NicoF46/EstimuladorTermico/README.md

# EstimuladorTermico
Estimulador térmico para trabajo profesional
