NicoF46/EstimuladorTermico/Documentacion/ModeloTermico/ConductividadTermicaTabla.png

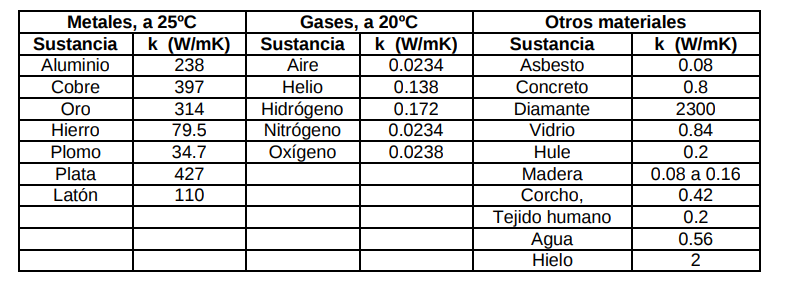
Documentacion/ModeloTermico/ConductividadTermicaTabla.png
