NicoF46/EstimuladorTermico/Documentacion/Plaquetas/Placa V2/esquematico.png

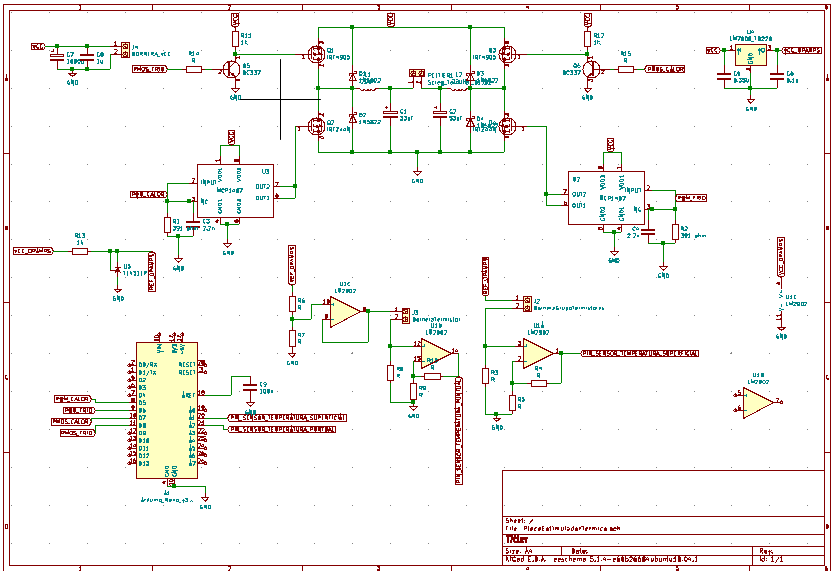
Documentacion/Plaquetas/Placa V2/esquematico.png
