NicoF46/EstimuladorTermico/Documentacion/Plaquetas/Placa V2/Schematic.pdf

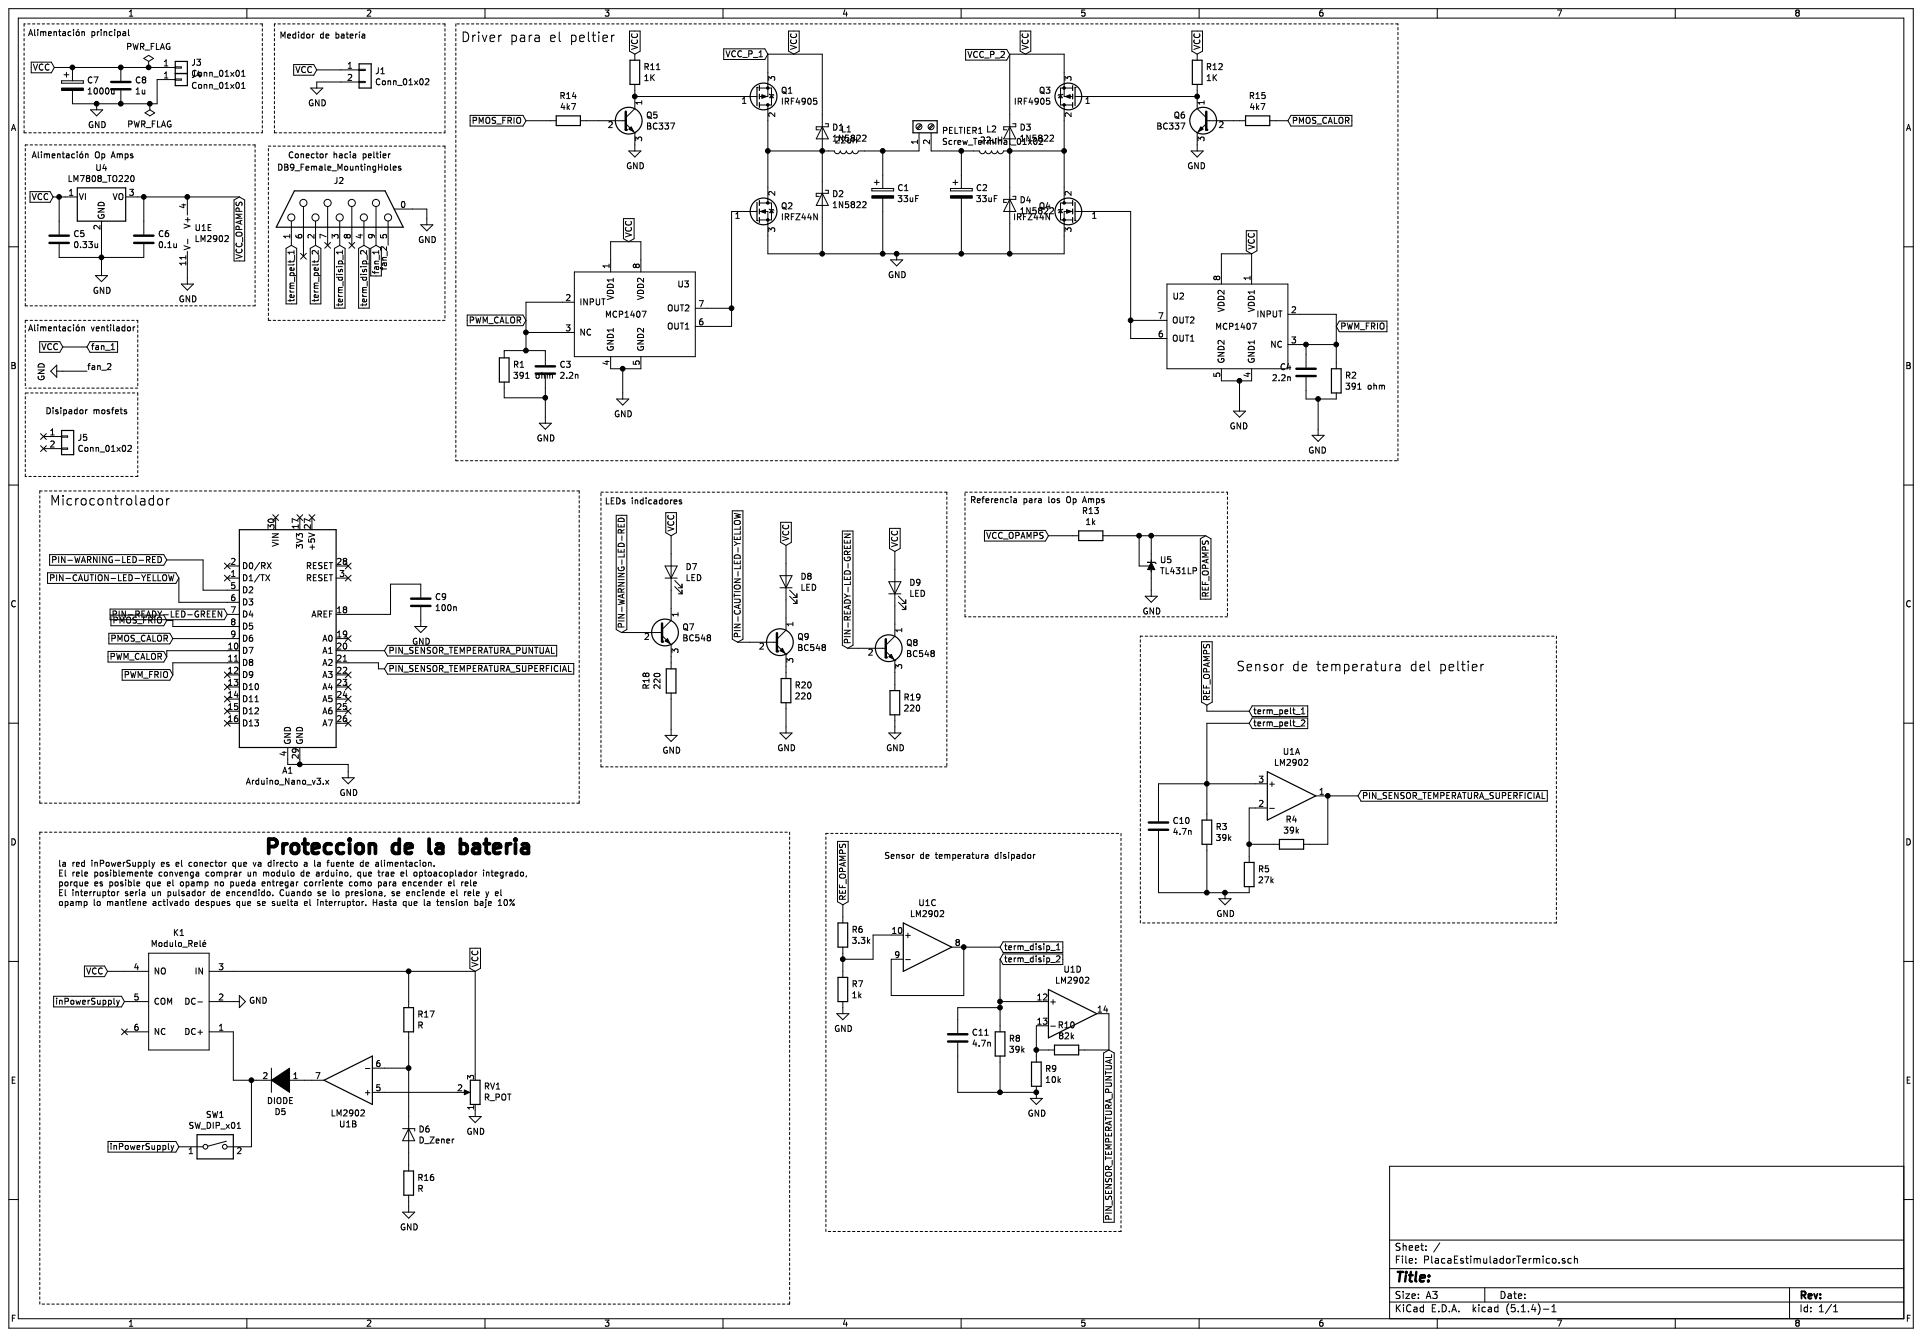
[picture p24: page 1]
