NicoF46/EstimuladorTermico/Documentacion/Circuitos/Limitador 10V con rele.asc

Carga: res; 1.5
D1: zener; 1N750
D2: diode; 1N4148
L1: ind; 50µ
R1: res; {AA*(1-A)}
R2: res; {A*AA}
R3: res; {BB*(1-B)}
R4: res; {BB*B}
R7: res; 500
S1: sw; MYSW
S3: sw; MYSW
U1: OP07
V1: voltage; PULSE(8 12 0 0 0 50m 100m)
V2: voltage; PULSE(0 12 0 0 0 10m 20m 1)
Named nets: 0, vA, vB, Vbat, vSW
.tran 500m
.model MYSW SW(Ron=0.01 Roff=100Meg Vt=2 Vh=0)
.param Vcut=10; Tension de corte del coso
.param Vnom=12; Tension nominal
;:::::Parametros del zener:::::
.param Vz=4.7; Tension del zenner
.param Iz=30m; Corriente aprox
;::::Segundo divisor resistivo::::
.param BB=(Vnom-Vz)/Iz
.param B=0.5
;::::Primer divisor resistivo::::
.param AA=5meg; suma del primer divisor
.param A=(Vz+B*(Vcut-Vz))/Vcut
.model 1N750b ako: 1N750 bv=3
La fuente V1 vendria a ser la bateria. La puse como rampa para simular al descarga.
La fuente V2 simula ser un pulsador normal abierto. La idea es que para arrancar el
equipo tocas el pulsador, el opamp se activa y mantiene el gate del mosfet activo.
 
Inverti el sentido de las tensiones en la entrada del opamp, para que la salida este high cuando la bateria esta ok.
Tambien movi el mosfet a la entrada, de forma que con un solo switch se corte la alimentacion de la protección y del equipo
 
Los parametros definidos a la derecha salen de hacer las cuentas viendo cuando la tension de entrada del opamp esta en cero
.inc C:\\Users\\FrancoPieza\\Desktop\\irfz44.lib
.inc C:\\Users\\FrancoPieza\\Desktop\\irf4905.lib
