NicoF46/EstimuladorTermico/Documentacion/Circuitos/CircuitoControl.asc

M1: nmos; irfz44n
M2: nmos; irfz44n
R1: res; 0.8
R4: res; 10k
R5: res; 2k
R6: res; 2k
R7: res; 10k
R8: res; 1k
Rl: res; 0.8
RS: res; 0.2
U1: opamp2; LMX24_LM2902
U2: opamp2; LMX24_LM2902
V1: voltage; 12
V2: voltage; PULSE(0 5 0.1 2 2 2 8)
V3: voltage; 0
V4: voltage; ""
Named nets: 0, VCC, VNN, VG, VS, Vin
.inc C:\\Users\
ico\\Documents\\CalientaManos\\irfz44.lib
;tran 0 3 0 .1 uic
.inc C:\\Users\
ico\\Documents\\CalientaManos\\LMx24_LM2902.cir
.dc V4 0 8 .1
