NicoF46/EstimuladorTermico/Documentacion/Circuitos/ProteccionCorriente/Proteccion.asc

C1: cap; 100µ
D1: zener; 1N750
D2: zener; 1N750
L1: ind; 22µ
Peltier: res; 2
S1: sw; switch
S2: sw; switch
V1: voltage; 12
V2: voltage; PULSE(0 1 45u 1f 1f 45u 50u)
V3: voltage; PULSE(0 1 0 1f 1f 45u 50u)
Named nets: 0, Q, nQ, out
.tran 0 2m 0
.model switch sw(Ron=.001,Roff=10meg,Vt=.5,Vh=0)
Protección
