NicoF46/EstimuladorTermico/Documentacion/Plaquetas/Placa Proteccion/PlacaProteccion.kicad_pcb

## KiCad design Documentacion/Plaquetas/Placa Proteccion/PlacaProteccion.kicad_pcb (2020-03-20)

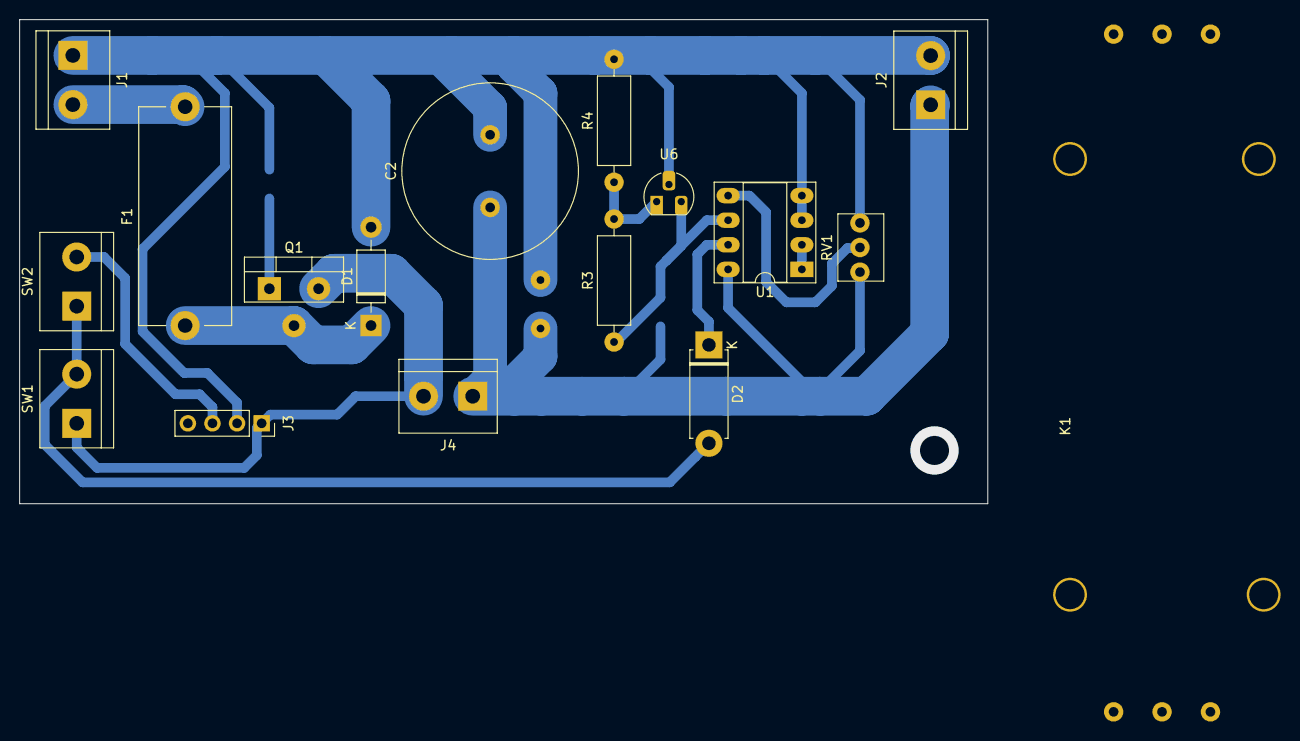
[picture p25: board PlacaProteccion.kicad_pcb from above]

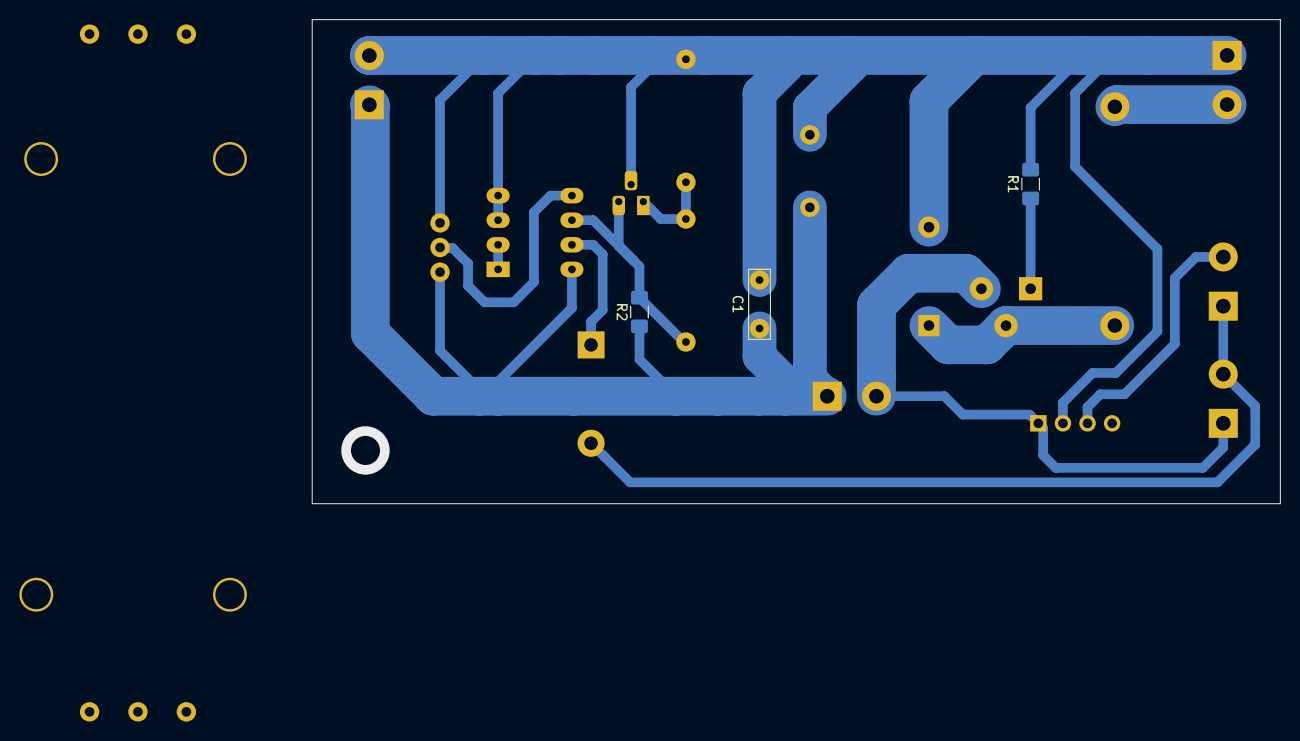
[picture p26: board PlacaProteccion.kicad_pcb from below]

Board: 2 copper layers, 100.0 x 50.0 mm, 20 parts (3 on the bottom side), 13 nets.

Parts:
C1: 1u; C_Rect_L7.0mm_W2.0mm_P5.00mm
C2: 1000u; C_Radial_D18.0mm_H35.5mm_P7.50mm
D1: 1N4007; D_DO-41_SOD81_P10.16mm_Horizontal
D2: DIODE; D_5W_P10.16mm_Horizontal
F1: Fuse; Fuseholder_Cylinder-5x20mm_Stelvio-Kontek_PTF78_Horizontal_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
J1: POW_IN; TerminalBlock_bornier-2_P5.08mm
J2: POW_OUT; TerminalBlock_bornier-2_P5.08mm
J3: RELAY_CTRL; PinSocket_1x04_P2.54mm_Vertical
J4: RELAY_SW; TerminalBlock_bornier-2_P5.08mm
K1: Modulo_Relé; Modulo_Relé_Arduino
Q1: IRF4905; TO-220-3_Vertical
R1: 100k; R_1206_3216Metric_Pad1.42x1.75mm_HandSolder
R2: 1.5k; R_1206_3216Metric_Pad1.42x1.75mm_HandSolder
R3, R4: 100k; R_Axial_DIN0309_L9.0mm_D3.2mm_P12.70mm_Horizontal
RV1: R_POT; Potentiometer_Bourns_3266Y_Vertical
SW1: ON_SW; TerminalBlock_bornier-2_P5.08mm
SW2: OFF_SW; TerminalBlock_bornier-2_P5.08mm
U1: LM2903; DIP-8_W7.62mm_Socket_LongPads
U6: TL431LP; TO-92_HandSolder

Connections:
unnamed: D1.1, F1.1, Q1.2
unnamed: D2.1, U1.7
unnamed: D2.2, SW1.2, SW2.1
unnamed: J3.3, SW2.2
unnamed: Q1.1, R1.1
unnamed: R2.2, R3.1, U1.6, U6.3
unnamed: R3.2, R4.1, U6.1
unnamed: RV1.2, U1.5
unnamed: U1.1, U1.2
POW_IN+: F1.2, J1.2
POW_IN-: C1.2, C2.2, D1.2, J1.1, J2.2, J3.2, R1.2, R4.2, RV1.1, U1.3, U1.4, U6.2
RELAY_COM: J3.1, J4.2, Q1.3, SW1.1
RELAY_NO: C1.1, C2.1, J2.1, J4.1, R2.1, RV1.3, U1.8
