NicoF46/EstimuladorTermico/Documentacion/Plaquetas/Placa Potencia/PlacaPotencia.kicad_pcb

## KiCad design Documentacion/Plaquetas/Placa Potencia/PlacaPotencia.kicad_pcb (2020-02-07)

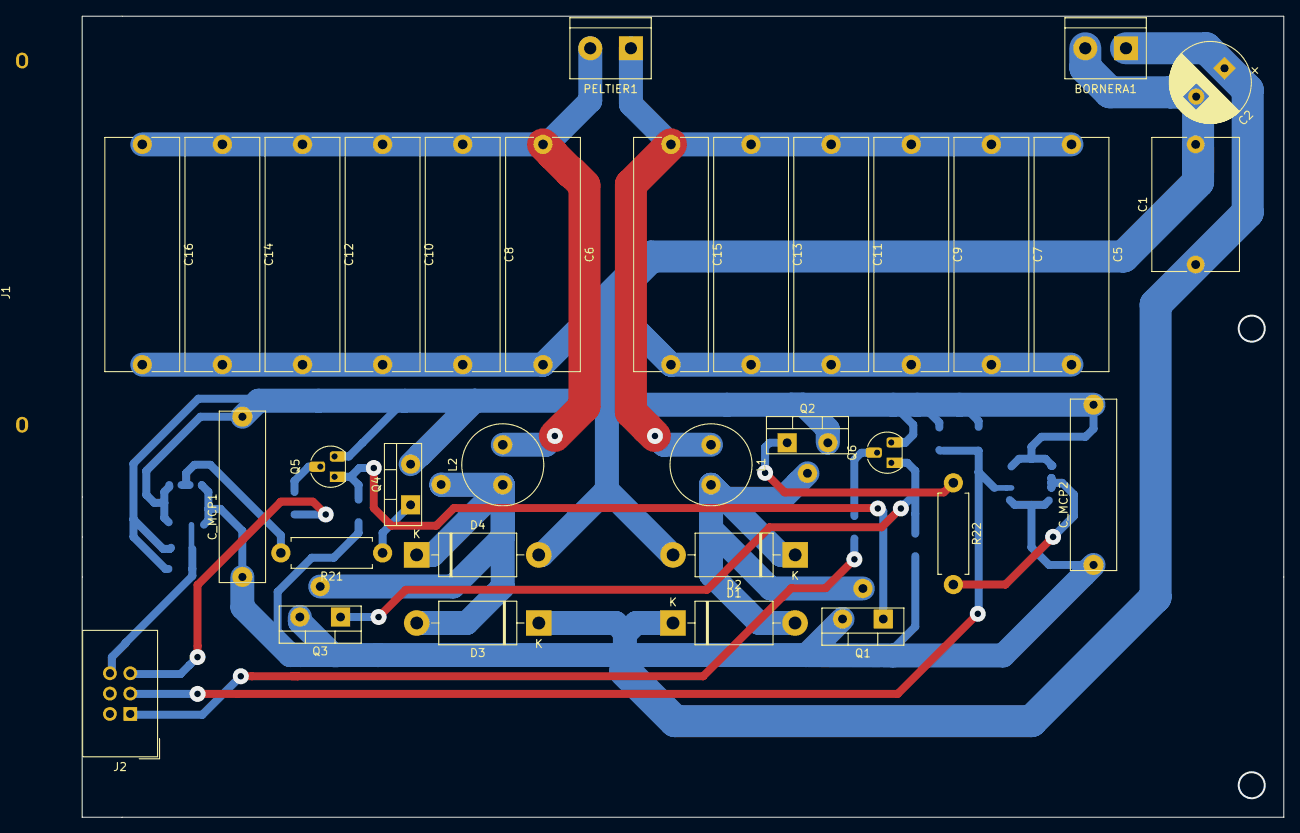
[picture p27: board PlacaPotencia.kicad_pcb from above]

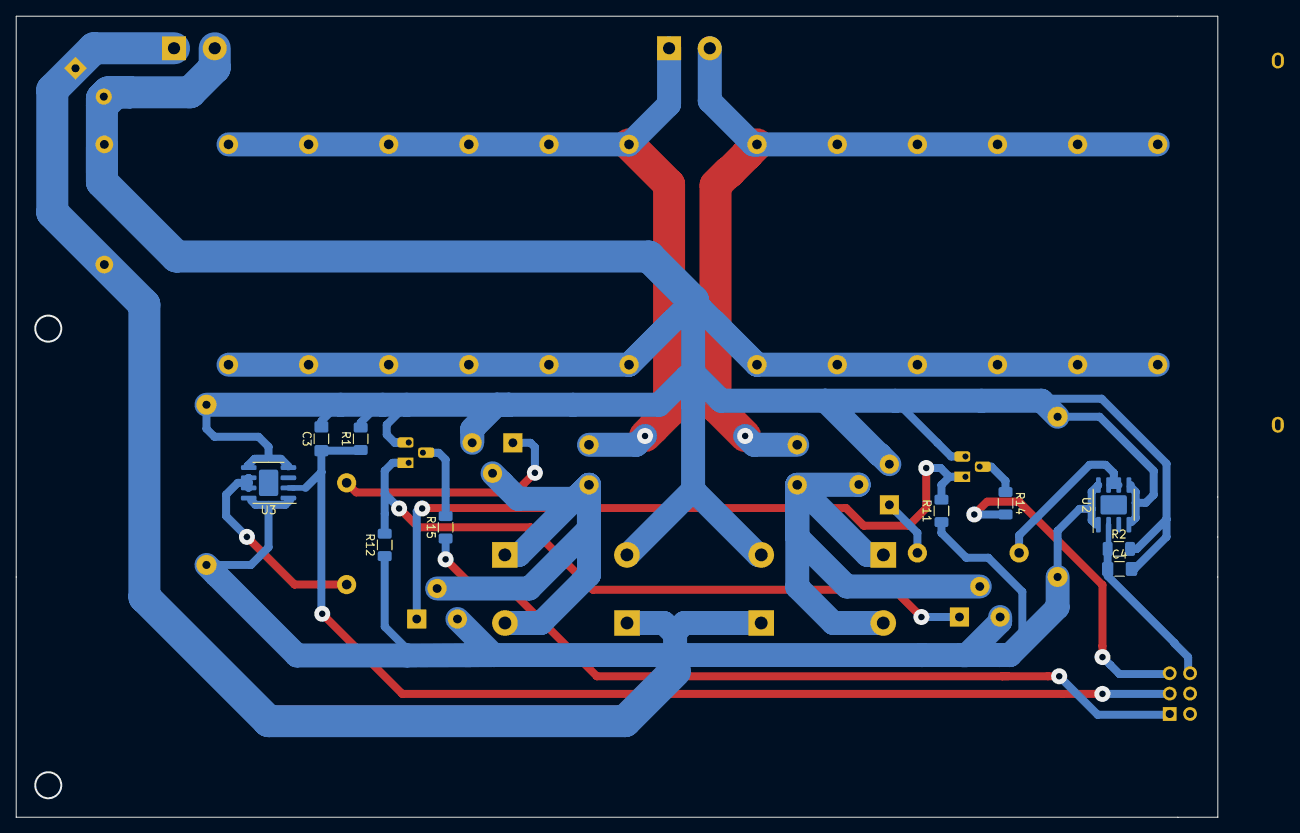
[picture p28: board PlacaPotencia.kicad_pcb from below]

Board: 2 copper layers, 150.0 x 100.0 mm, 44 parts (10 on the bottom side), 18 nets.

Parts:
BORNERA1: Screw_Terminal_01x02; TerminalBlock_bornier-2_P5.08mm
C1: 1u; C_Rect_L16.5mm_W10.7mm_P15.00mm_MKT
C2: 1000u; CP_Radial_D10.0mm_P5.00mm
C3, C4: 2.2n; C_1206_3216Metric_Pad1.42x1.75mm_HandSolder
C5, C6, C7, C8, C9, C10, C11, C12, C13, C14, C15, C16: 4.7u; C_Rect_L29.0mm_W9.1mm_P27.50mm_MKT
C_MCP1, C_MCP2: 680n; C_Rect_L21.5mm_W5.5mm_P20.00mm_MKS4
D1, D2, D3, D4: 1N5822; D_DO-201AD_P15.24mm_Horizontal
J1: Conn_01x02_Male; disipadorFETS
J2: Conn_01x06_Male; IDC-Header_2x03_P2.54mm_Vertical
L1, L2: 22uH; L_Radial_D10.0mm_P5.00mm_Neosid_SD12k_style3
PELTIER1: Screw_Terminal_01x02; TerminalBlock_bornier-2_P5.08mm
Q1, Q3: IRF4905; TO-220-3_Vertical
Q2, Q4: IRFZ44N; TO-220-3_Vertical
Q5, Q6: BC337; TO-92_HandSolder
R1, R2: 391 ohm; R_1206_3216Metric
R11, R12: 1K; R_1206_3216Metric
R14, R15: 4k7; R_1206_3216Metric
R21, R22: 15; R_Axial_DIN0411_L9.9mm_D3.6mm_P12.70mm_Horizontal
U2, U3: MCP1407; SOIC-8-1EP_3.9x4.9mm_P1.27mm_EP2.41x3.3mm

Connections:
GND: BORNERA1.2, C1.2, C2.2, C3.2, C4.2, C5.2, C6.2, C7.2, C8.2, C9.2, C10.2, C11.2, C12.2, C13.2, C14.2, C15.2, C16.2, C_MCP1.2, C_MCP2.2, D2.2, D4.2, Q2.3, Q4.3, Q5.3, Q6.3, R1.2, R2.2, U2.4, U2.5, U3.4, U3.5
unnamed: D1.2, D2.1, L1.2, Q1.2, Q2.2
unnamed: D3.2, D4.1, L2.1, Q3.2, Q4.2
unnamed: Q1.1, Q5.1, R11.2
unnamed: Q2.1, R22.1
unnamed: Q3.1, Q6.1, R12.2
unnamed: Q4.1, R21.1
unnamed: Q5.2, R14.1
unnamed: Q6.2, R15.2
unnamed: R21.2, U2.6, U2.7
unnamed: R22.2, U3.6, U3.7
PELTIER1: C5.1, C7.1, C9.1, C11.1, C13.1, C15.1, L1.1, PELTIER1.1
PELTIER2: C6.1, C8.1, C10.1, C12.1, C14.1, C16.1, L2.2, PELTIER1.2
PMOS_CALOR: J2.1, R15.1
PMOS_FRIO: J2.5, R14.2
PWM_CALOR: C3.1, J2.3, R1.1, U3.2
PWM_FRIO: C4.1, J2.6, R2.1, U2.2
VCC: BORNERA1.1, C1.1, C2.1, C_MCP1.1, C_MCP2.1, D1.1, D3.1, Q1.3, Q3.3, R11.1, R12.1, U2.1, U2.8, U3.1, U3.8
