NicoF46/EstimuladorTermico/Documentacion/Plaquetas/Placa V2/PlacaEstimuladorTermico.kicad_pcb

## KiCad design Documentacion/Plaquetas/Placa V2/PlacaEstimuladorTermico.kicad_pcb (2020-01-01)

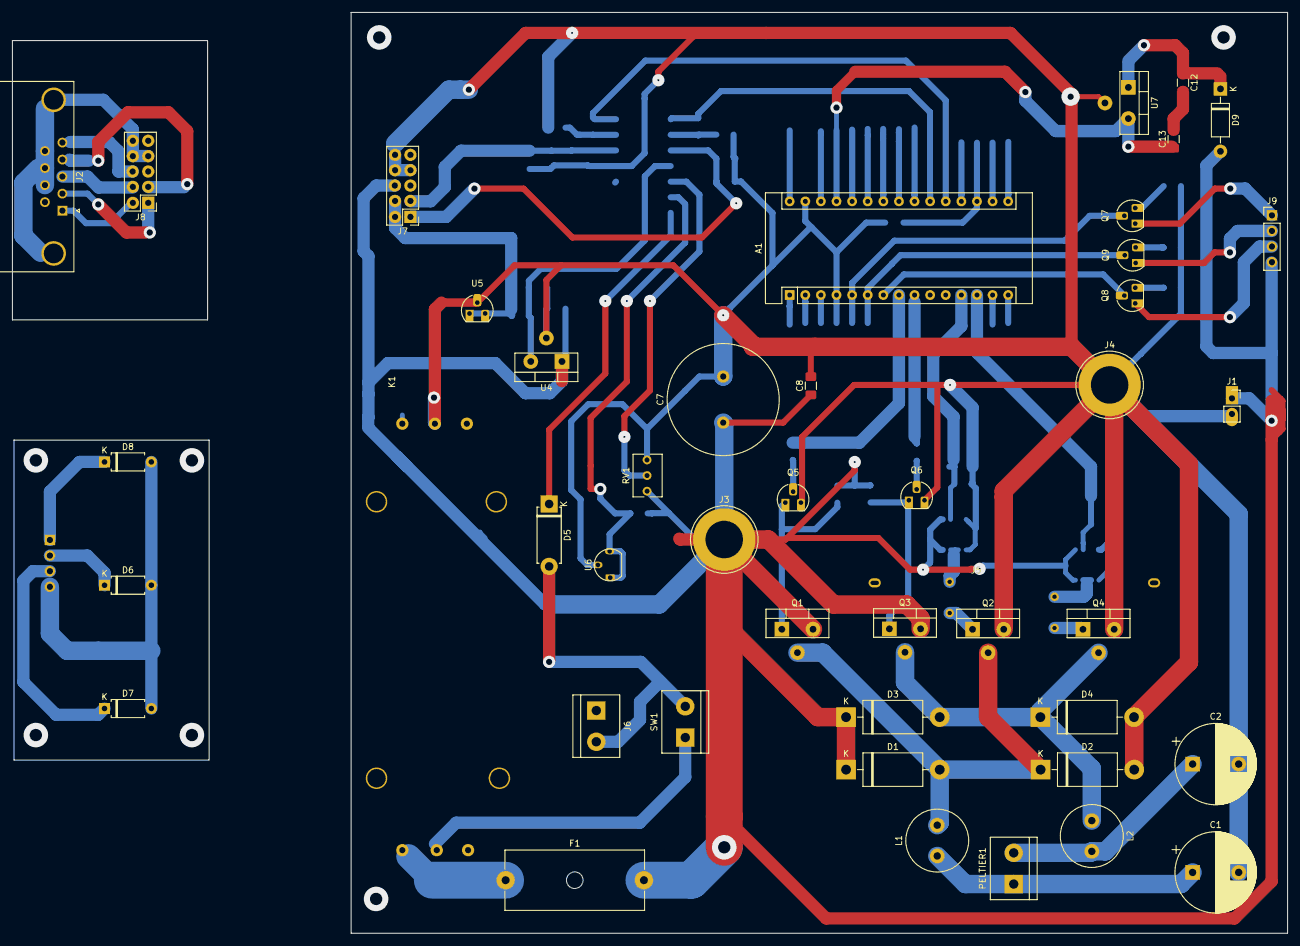
[picture p29: board PlacaEstimuladorTermico.kicad_pcb from above]

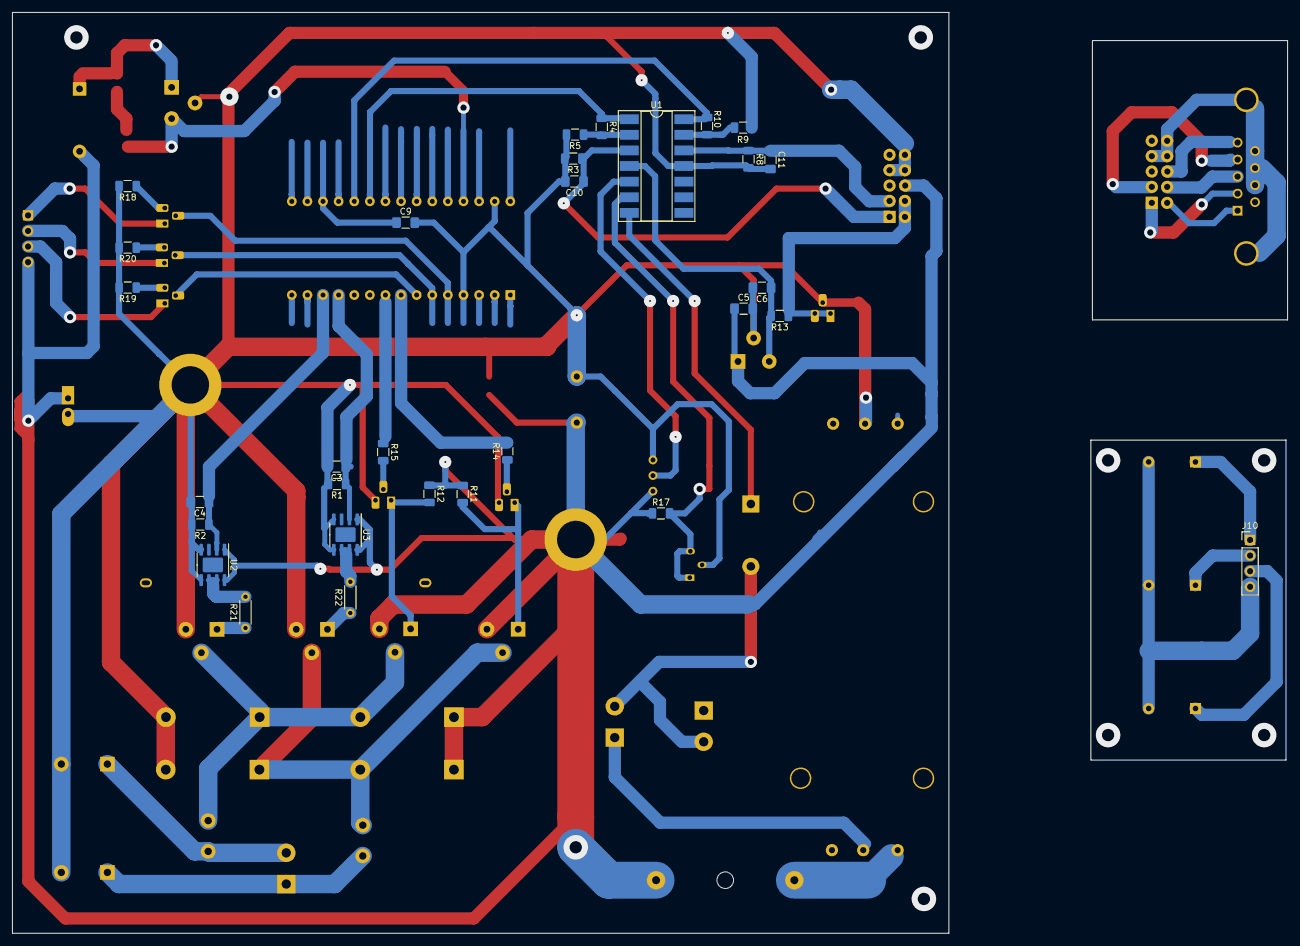
[picture p30: board PlacaEstimuladorTermico.kicad_pcb from below]

Board: 2 copper layers, 152.4 x 149.9 mm, 75 parts (30 on the bottom side), 56 nets.

Parts:
A1: Arduino_Nano_v3.x; Arduino_Nano
C1, C2: 33uF; CP_Radial_D13.0mm_P7.50mm
C3, C4: 2.2n; C_1206_3216Metric_Pad1.42x1.75mm_HandSolder
C5, C12: 0.33u; C_1206_3216Metric_Pad1.42x1.75mm_HandSolder
C6, C13: 0.1u; C_1206_3216Metric_Pad1.42x1.75mm_HandSolder
C7: 1000u; C_Radial_D18.0mm_H35.5mm_P7.50mm
C8: 1u; C_1206_3216Metric_Pad1.42x1.75mm_HandSolder
C9: 100n; C_1206_3216Metric_Pad1.42x1.75mm_HandSolder
C10: 4.7n; C_1206_3216Metric_Pad1.42x1.75mm_HandSolder
C11: 47n; C_1206_3216Metric_Pad1.42x1.75mm_HandSolder
D1, D2, D3, D4: 1N5822; D_DO-201AD_P15.24mm_Horizontal
D5: DIODE; D_5W_P10.16mm_Horizontal
D6: Yellow; D_A-405_P7.62mm_Horizontal
D7: Green; D_A-405_P7.62mm_Horizontal
D8: RED; D_A-405_P7.62mm_Horizontal
D9: 1N4002; D_DO-41_SOD81_P10.16mm_Horizontal
F1: Fuse; Fuseholder_Cylinder-5x20mm_Schurter_0031_8201_Horizontal_Op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
J1: Conn_01x02; PinSocket_1x02_P2.54mm_Vertical
J2: DB9_Female_MountingHoles; DSUB-9_Female_Horizontal_P2.77x2.84mm_EdgePinOffset7.70mm_H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
J3, J4: Conn_01x01; Banana_Jack_1Pin
J5: Conn_01x02; disipadorFETS
J6: Pulsador OFF; TerminalBlock_bornier-2_P5.08mm
J7: Conn_02x05_Counter_Clockwise; PinHeader_2x05_P2.54mm_VerticalNico
J8: Conn_02x05_Counter_Clockwise; PinHeader_2x05_P2.54mm_Vertical
J9, J10: Conn_01x04_Male; PinHeader_1x04_P2.54mm_Vertical
K1: Modulo_Relé; Modulo_Relé_Arduino
L1, L2: 22uH; L_Radial_D10.0mm_P5.00mm_Neosid_SD12k_style3
PELTIER1: Screw_Terminal_01x02; TerminalBlock_bornier-2_P5.08mm
Q1, Q3: IRF4905; TO-220-3_Vertical
Q2, Q4: IRFZ44N; TO-220-3_Vertical
Q5, Q6: BC337; TO-92_HandSolder
Q7, Q8, Q9: BC548; TO-92_HandSolder
R1, R2: 391 ohm; R_1206_3216Metric
R3, R4: 39k; R_1206_3216Metric
R5: 27k; R_1206_3216Metric
R8, R9, R10: 10k; R_1206_3216Metric
R11, R12: 1K; R_1206_3216Metric
R13: 1k; R_1206_3216Metric
R14, R15: 4k7; R_1206_3216Metric
R17: 1.5k; R_1206_3216Metric
R18, R19, R20: 220; R_1206_3216Metric
R21, R22: 15; R_Axial_DIN0204_L3.6mm_D1.6mm_P5.08mm_Horizontal
RV1: R_POT; Potentiometer_Bourns_3266Y_Vertical
SW1: Pulsador ON; TerminalBlock_bornier-2_P5.08mm
U1: LM2902; DIP-14_W8.89mm_SMDSocket_LongPads
U2, U3: MCP1407; SOIC-8-1EP_3.9x4.9mm_P1.27mm_EP2.41x3.3mm
U4: LM7808_TO220; TO-220-3_Vertical
U5: TL431LP; TO-92_HandSolder
U6: TL431LP; TO-92_Inline
U7: L7805; TO-220-3_Vertical

Connections:
GND: A1.4, A1.29, C1.2, C2.2, C3.2, C4.2, C5.2, C6.2, C7.2, C8.2, C9.2, C10.2, C11.2, D2.2, D4.2, J1.2, J4.1, J7.4, J7.6, J7.7, K1.2, Q2.3, Q4.3, Q5.3, Q6.3, R1.2, R2.2, R3.2, R5.2, R8.2, R9.2, R18.2, R19.2, R20.2, RV1.1, U1.11, U2.4, U2.5, U3.4, U3.5, U4.2, U5.2, U6.2, U7.2
unnamed: A1.18, C9.1
unnamed: A1.27, C13.1, U7.3
unnamed: C1.1, L1.1, PELTIER1.1
unnamed: C2.1, L2.2, PELTIER1.2
unnamed: C12.1, D9.1, U7.1
unnamed: C12.2, C13.2
unnamed: D1.2, D2.1, L1.2, Q1.2, Q2.2
unnamed: D3.2, D4.1, L2.1, Q3.2, Q4.2
unnamed: D5.1, U1.7
unnamed: D5.2, J6.2, SW1.2
unnamed: D6.1, J10.2
unnamed: D6.2, D7.2, D8.2, J10.4
unnamed: D7.1, J10.3
unnamed: D8.1, J10.1
unnamed: F1.1, K1.4
unnamed: J6.1, K1.3
unnamed: J9.1, Q7.1
unnamed: J9.2, Q9.1
unnamed: J9.3, Q8.1
unnamed: Q1.1, Q5.1, R11.2
unnamed: Q2.1, R22.1
unnamed: Q3.1, Q6.1, R12.2
unnamed: Q4.1, R21.1
unnamed: Q5.2, R14.1
unnamed: Q6.2, R15.2
unnamed: Q7.3, R18.1
unnamed: Q8.3, R19.1
unnamed: Q9.3, R20.1
unnamed: R4.2, R5.1, U1.2
unnamed: R9.1, R10.2, U1.13
unnamed: R17.2, U1.6, U6.1, U6.3
unnamed: R21.2, U2.6, U2.7
unnamed: R22.2, U3.6, U3.7
unnamed: RV1.2, U1.5
PIN-CAUTION-LED-YELLOW: A1.6, Q9.2
PIN-READY-LED-GREEN: A1.7, Q8.2
PIN-WARNING-LED-RED: A1.5, Q7.2
PIN_SENSOR_TEMPERATURA_PUNTUAL: A1.20, R10.1, U1.14
PIN_SENSOR_TEMPERATURA_SUPERFICIAL: A1.21, R4.1, U1.1
PMOS_CALOR: A1.9, R15.1
PMOS_FRIO: A1.8, R14.2
PWM_CALOR: A1.12, C3.1, R1.1, U3.2
PWM_FRIO: A1.13, C4.1, R2.1, U2.2
REF_OPAMPS: J7.9, J7.10, R13.1, U5.1, U5.3
VCC: C5.1, C7.1, C8.1, D1.1, D3.1, D9.2, F1.2, J1.1, J3.1, J7.8, J9.4, Q1.3, Q3.3, R11.1, R12.1, R17.1, RV1.3, U2.1, U2.8, U3.1, U3.8, U4.1
VCC_OPAMPS: C6.1, R13.2, U1.4, U4.3
fan_1C: J2.5, J8.8
fan_2C: J2.0, J2.7, J2.8, J2.9, J8.4, J8.6, J8.7
inPowerSupply: K1.1, K1.5, SW1.1
term_disip_1C: J2.3, J8.9
term_disip_2: C11.1, J7.2, R8.1, U1.12
term_disip_2C: J2.4, J8.2
term_pelt_1C: J2.1, J8.10
term_pelt_2: C10.1, J7.1, R3.1, U1.3
term_pelt_2C: J2.2, J8.1
