NicoF46/EstimuladorTermico/Codigo/firmware/dev/status.h

#ifndef STATUS_H
#define STATUS_H

#include <stdint.h>
#include <stddef.h>

/*-----------------------------------------------------------------------------
  Library data types
-----------------------------------------------------------------------------*/

typedef enum
{
  STANDBY,
  COLD,
  HOT,
  COLD_REACHED,
  HOT_REACHED,
  PWM_COLD,
  PWM_HOT,
  ERROR
} status_t;

/* ----------------------------------------------------------------------------
  Function prototypes
------------------------------------------------------------------------------*/

void status_setup();
void status_test_start();
void status_test_end();
void status_set( const status_t status );
status_t status_get();
void status_temperature_reached_set();

#endif
