NicoF46/EstimuladorTermico/Codigo/firmware/dev/water_cooler.h

#ifndef WATER_COOLER_H
#define WATER_COOLER_H

#include <stdbool.h>

/* ----------------------------------------------------------------------------
  Function prototypes
------------------------------------------------------------------------------*/

void water_cooler_setup();
unsigned int water_cooler_fan_rpm_get();
void water_cooler_tachometer_check();
bool water_cooler_is_on_error();

#endif
