NicoF46/EstimuladorTermico/Codigo/firmware/dev/keep_alive.h

#ifndef KEEP_ALIVE_H
#define KEEP_ALIVE_H

#include <stdbool.h>

/* ----------------------------------------------------------------------------
  Function prototypes
------------------------------------------------------------------------------*/

void keep_alive_delay_set( const unsigned int delay );
void keep_alive_reset();
bool keep_alive_wait();

#endif
