NicoF46/EstimuladorTermico/Codigo/firmware/dev/usart.h

#include <avr/io.h>
#include <stdbool.h>

void usart_init();
void usart_transmit( uint8_t );
void usart_buffer_transmit( const void*, const int size );
uint8_t usart_receive( bool* parity_error );
void usart_flush( void );
