NicoF46/EstimuladorTermico/(commit log)

2019-04-15 Agrego carpeta para almacenar informacion util del peltier y un par de documentos en la misma
2019-04-15 Agrego resumen de los umbrales de dolor y experimento de la mano plastica
2019-04-15 Cambio archivo a la carpeta correcta
2019-04-19 Agrego el codigo para sensar temperatura con el fabuloso termistor de mati
2019-04-25 PWM y cambio a divisor resistivo
    Hecho el 24/04 en el LABI. Se cambio de medicion con puente de wheatstone a divisor resistivo con salida sobre resistencia fija.
    PWM en pin 6 controla la tension de gate del MOSFET
2019-05-10 finished the devices's client side in python
2019-05-14 added a new csv with data
    [pwm255frio.csv]
2019-05-14 Calculo del modelo térmico del Peltier
    Se agrego la documentación en la cual se basaron los cálculos para obtener el modelo térmico del Peltier junto con el código utilizado para obtener los parámetros.
2019-05-14 now the device transmit the pwm
2019-05-14 deleted senartemperaturacontermistor
    [prueba_PID_10C.csv]
2019-05-14 added a .gitignore file to ignore .pyc files
    [prueba_PID_10C.csv]
2019-05-15 another test of the PID feedback
2019-05-15 Agrego los modos para que enfrie o caliente segun la referencia
2019-05-15 calibrated the pid
2019-05-19 started to modify the new circuit's firmware
2019-05-20 changed the PID controller
2019-05-21 Now the device receive the temperature via serial interface
2019-05-22 started a cmd interface to send messages to the device
2019-05-22 finished the first version of the device
2019-08-20 fixing a bug when detecting the usb port
    [data_acquisition.py]
2019-08-27 Updated peltier model estimation
    [openloop5V.csv, openloopHand5V.csv]
2019-09-06 Subo las simulaciones del informe correspondientes al circuito de control, me faltan las simulaciones del H bridge, la simulacion asi como la configure tarda un toque.
2019-09-06 Minor changes to peltier model estimation
    [openloopHand1A.csv]
2019-09-29 Subo codigo del control en C
    [LazoAbiertoPWM255.csv]
2019-10-01 Agrego jpg con el circuito de la placa de mati, cambie las resistencias de los mos de 100k a 10k, agregue el filtro LC y diodos flyback
2019-10-01 Simulación Circuito Protección
2019-10-02 Arreglo la transmision serie del arduino a la pc, me falta arreglar la de pc a arduino
    [ConfiguracionSerial.c, main.c]
2019-10-03 Resolvi el problema de la comunicacion, probe el codigo del pid funciona, tengo que ajustarlo y hacer la funcion de calibracion, dato a color el disipador con el filtro no calienta ni enfria como ant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
    [main.c]
2019-10-05 Agrego el codigo para la calibracion
2019-10-14 Agrego el esquematico de la version 2 de la placa, me faltan algunos valores de resistencias y protecciones
    [PlacaEstimuladorTermico.kicad_pcb, PlacaEstimuladorTermico.sch]
2019-10-14 Agrego la resistencia en los mos
    [PlacaEstimuladorTermico.sch]
2019-10-17 Agrego el esquematico en png para mostrarlo hoy
2019-10-22 I selected the commercial components values and added to the schematic, I dont know if all the lines are connected correctly so please someone revise
    [PlacaEstimuladorTermico.sch]
2019-10-30 Add files via upload
    Actualizacion de esquematico: agregada proteccion de bateria
    [PlacaEstimuladorTermico.sch]
2019-11-01 Adding indicator lights and values to components
    [PlacaEstimuladorTermico.sch]
2019-11-02 I add all the footprints, the position of the high power mosfets is in acordance with a heatsink that I had
    [PlacaEstimuladorTermico.sch]
2019-11-04 I designed the pcb, it was my first try so please check every wire
    [PlacaEstimuladorTermico.kicad_pcb]
2019-11-07 Add battery level to scheme, protection circuit correction & arranging
    [PlacaEstimuladorTermico.sch]
2019-11-07 add relay module symbol and footprint, modify mcp1407 symbol
    plus updates of these on the schematic
    [PlacaEstimuladorTermico.sch]
2019-11-09 solve kicad library issues
2019-11-28 Change pins of pwm and on off, adjusting pins in code to correct the problem
    [main.c]
2019-12-03 DB9 board for peltier case
    [placa_db9.kicad_pcb, placa_db9.sch]
2019-12-03 DB9 board with bigger pads
    [placa_db9.kicad_pcb]
2019-12-08 Correction of all the errors in the pcb
    [PlacaEstimuladorTermico.kicad_pcb, PlacaEstimuladorTermico.sch]
2019-12-09 Correction of pwm pins
    [PlacaEstimuladorTermico.kicad_pcb, PlacaEstimuladorTermico.sch]
2019-12-15 Modification of the main board, add of leds circuit and db9 board
    [PlacaEstimuladorTermico.kicad_pcb, PlacaEstimuladorTermico.sch]
2019-12-15 Add holes to the board
    [PlacaEstimuladorTermico.kicad_pcb]
2019-12-15 Modifications in the schematic
    [PlacaEstimuladorTermico.sch]
2020-01-01 simplification of the dissipator temperature measurement circuit and simplification of code
    [PlacaEstimuladorTermico.kicad_pcb, PlacaEstimuladorTermico.sch]
2020-01-01 Add fuse and 7805 to supply the arduino nano
    [PlacaEstimuladorTermico.kicad_pcb]
2020-01-05 Divide pcb in sectors based in functionality
    [PlacaEstimuladorTermico.sch]
2020-01-22 Creation of power pcb
    [PlacaPotencia.kicad_pcb, PlacaPotencia.sch]
2020-01-23 Possible layout
    Needs some rearenging.
    Added kiCAD backup files to ignore list
    [PlacaPotencia.kicad_pcb, PlacaPotencia.sch]
2020-01-24 Power PCB Routed
    [PlacaPotencia.kicad_pcb, PlacaPotencia.sch]
2020-01-29 Power PCB revised
    Minor changes in size and vias
    [PlacaPotencia.kicad_pcb]
2020-02-02 Power PCB footprints updated
    [PlacaPotencia.kicad_pcb, PlacaPotencia.sch]
2020-02-03 Power PCB retraced routes for new footprints
    [PlacaPotencia.kicad_pcb]
2020-02-03 Power PCB complete route retracing
    [PlacaPotencia.kicad_pcb]
2020-02-05 Power PCB revision - via size, signal connector pos and front pow traces
    [PlacaPotencia.kicad_pcb]
2020-02-07 Power PCB changed logic connector, widened traces, added mounting holes
    [PlacaPotencia.kicad_pcb, PlacaPotencia.sch]
2020-03-04 Protection PCB creation
    Needs choosing inverse polarity connection protection method
    [PlacaProteccion.sch]
2020-03-05 Protection circuit on routed one sided 100x50mm board
    Relay outside board
    Possible improvements:
    - J3 moved left, decreases tracks length
    - U1 moved down, decreases tracks length, increases spacing between components
    [PlacaProteccion.kicad_pcb, PlacaProteccion.sch]
2020-03-18 Protection PCB footprint update, adjustable zenner ref set, pad resize
    [PlacaProteccion.kicad_pcb, PlacaProteccion.sch]
2020-03-20 Protection PCB widen tracks, connected unused opamp
    This is the final version. It was printed and etched
    [PlacaProteccion.kicad_pcb, PlacaProteccion.sch]
2020-06-06 Actualizacion del firmware por cambio en el hardware
2020-06-19 change pid and add commands for serial to work with flask
2020-07-12 Reorganising file composition
    [LazoAbiertoPWM255.csv, openloop5V.csv, openloopHand1A.csv, openloopHand5V.csv, pwm255frio.csv]
2020-07-18 fixin a bad identation
    [status.c]
2020-07-18 spliting status library into status and error library since some status and the NO_ERROR error state are compatibles
    [error.c, error.h, main.c, status.c]
2020-07-18 adding a command to set errors
    [commander.py]
2020-07-18 Fixing a missing path in the clean rule
    [error.c, main.c]
2020-07-19 Reading the temperature asynchronously
2020-07-28 adding a command to get the current pwm
2020-07-29 fixing a bug with the temperature used by reference
    [commander.py, error.c, main.c]
2020-08-08 Adding flags for each error
    [commander.py, error.c, error.h, main.c, status.c, status.h, usart.c, usart.h]
2020-08-13 Adding a parity error check for usart transmision
    [commander.py, error.c, main.c, usart.c, usart.h]
2020-08-13 Adding sound alarm when an error is set
    [error.h, main.c]
2020-08-17 Autogenerating functions to red and transmit commands frames
2020-08-23 Fiing a bug with the function read_chung in commander.py
    [commander.py, main.c]
2020-08-31 adding a temperature module
2020-08-31 adding a power_board library
2020-09-07 Adding measures to compare thermistors in different locations
    [cold_10_empty.csv, cold_10_hand.csv, cold_15_empty.csv, cold_15_hand.csv, cold_5_empty.csv, cold_5_hand.csv, hot_20_empty.csv, hot_20_hand.csv]
2020-09-10 adding a command that return the average temperature
2020-09-13 Adding stop command and fixig a bug where the live plot windows was always on top
    [commander.py, commands.c, live_plot.py]
2020-09-13 Swaping leds ports for the new board
    [error.c, status.c]
2020-09-20 adding a starting routine to test leds and the buzzer
    [error.c, error.h, main.c, status.c, status.h]
2020-10-13 Adding a keep alive that resets on each temperature_read command call
    [commander.py, commands.c, controller.c, error.c, keep_alive.c, keep_alive.h, main.c]
2020-10-17 first aproach to an error checker. Tachometer is not checked still
    [commander.py, controller.c, error.c, error.h, keep_alive.c, keep_alive.h, main.c, temperature.c]
2020-11-11 checking errors in the main loop
    [app_utils.c, commander.py, commands.c, controller.c, controller.h, error.c, live_plot.py, power_board.c]
2020-11-23 Checking if fan rpm are lower than half of its standard value
2020-11-24 Making the controller set the pwm to zero if the differece between temperature reference and the actual temp is higher than 13
2020-11-30 Setting a new flag to avoid the fan_rpm_error when the power is off
    [controller.c, error.c, status.c, status.h]
